jimbruges/birdbox/hardware/README.md

# BirdBox hardware

3D print files for BirdBox. Build instructions are in the main
[README](../README.md#building-the-hardware).

| File | What it is | Printing |
|---|---|---|
| `birdbox-mic-holder.stl` | Outdoor housing for the [Mini USB Microphone](https://thepihut.com/products/mini-usb-microphone) and its USB-C to USB-A adapter | Fill with silicone or hot glue after assembly, keeping the mic port clear |
| `birdbox-mic-holder.step` | Editable model of the mic holder | |
| `birdbox-servo-assembly-print-in-place.stl` | Linear servo assembly for an SG90-size servo (FS90R), printed in one piece | Mounting face on the build plate, organic supports |
| `birdbox-servo-assembly.step` | Editable model of the servo assembly | |
| `servo-gear.stl` | Pinion gear for the servo | |
| `servo-gear.step` | Editable model of the gear | |

## Credits and licence

The servo assembly is based on, and the servo gear comes from,
[Linear servo using SG90 9g servo](https://www.printables.com/model/1566678-linear-servo-using-sg90-9g-servo) by **lingeswaran** on Printables, licensed
Creative Commons Attribution (CC BY). The assembly has been modified for BirdBox.

These files are licensed under
[CC BY 4.0](https://creativecommons.org/licenses/by/4.0/). If you share or remix
them, credit both BirdBox and the original design.
