jimbruges/birdbox/docs/images/stills/15_cloud_dashboard.png

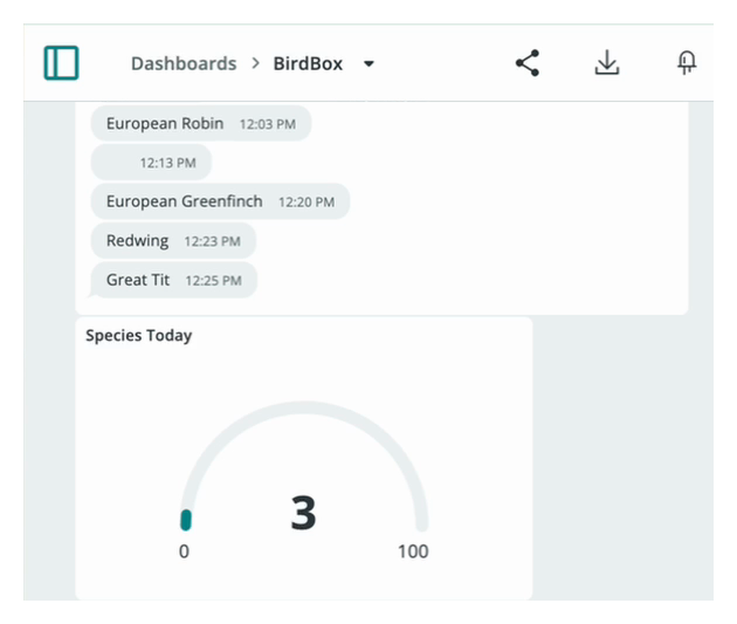
docs/images/stills/15_cloud_dashboard.png
