jimbruges/birdbox/hardware/birdbox-servo-assembly-print-in-place.stl

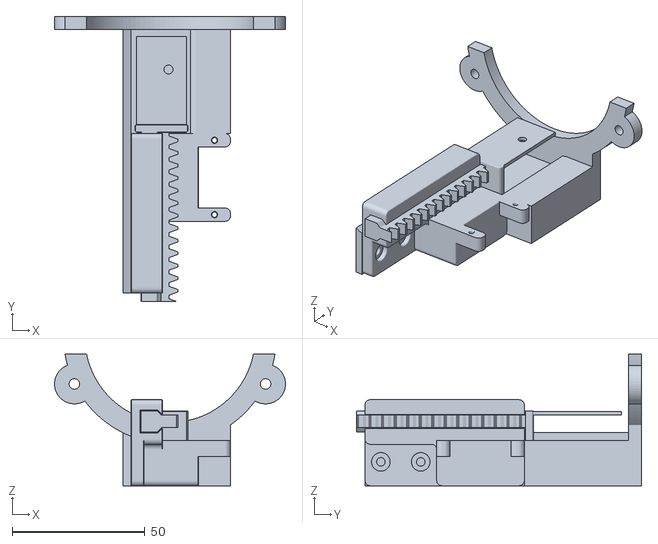
[picture p25: CAD file, 2026-11-09]
hardware/birdbox-servo-assembly-print-in-place.stl
86.9 x 107.3 x 49.5
