jimbruges/birdbox/hardware/birdbox-servo-assembly.step

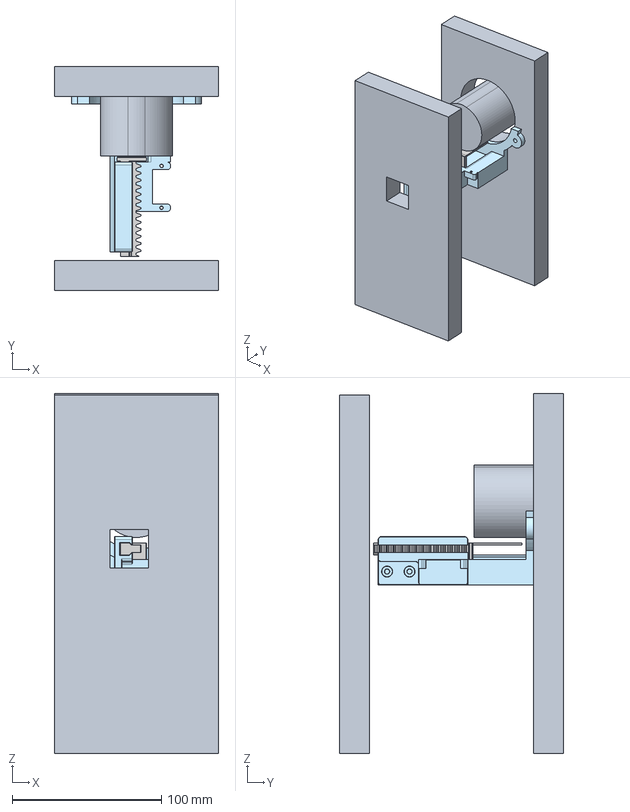
[picture p26: CAD file, 2026-11-09]
hardware/birdbox-servo-assembly.step
110.0 x 150.0 x 241.0 mm
