jimbruges/birdbox/hardware/birdbox-mic-holder.step

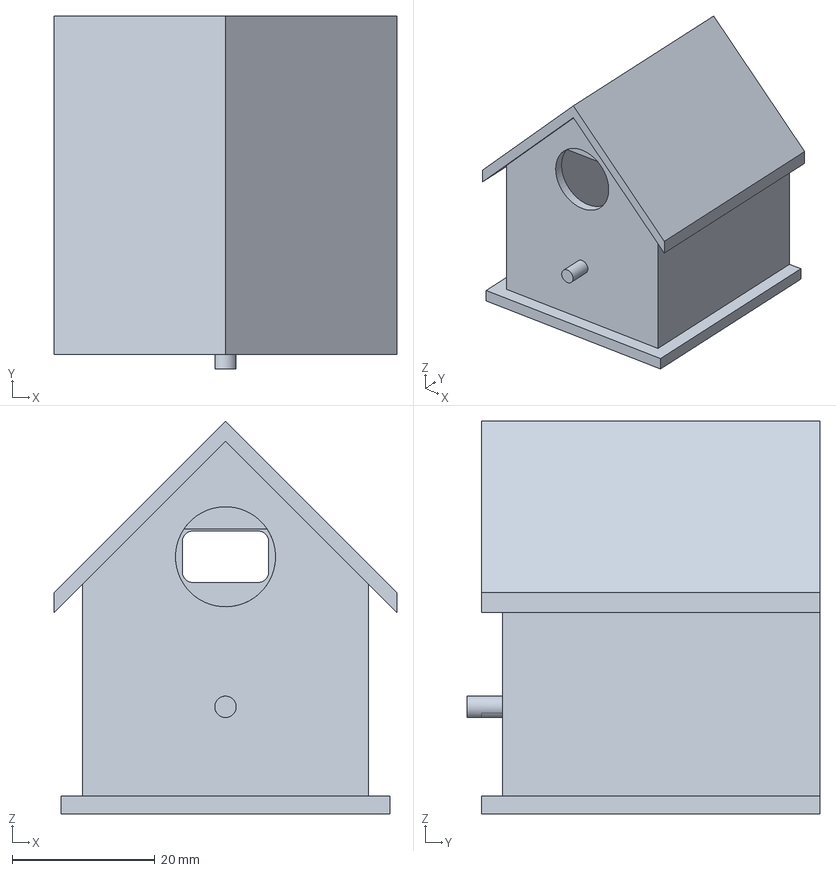
[picture p27: CAD file, 2026-11-09]
hardware/birdbox-mic-holder.step
48.0 x 49.4 x 55.0 mm
