jimbruges/birdbox/hardware/servo-gear.step

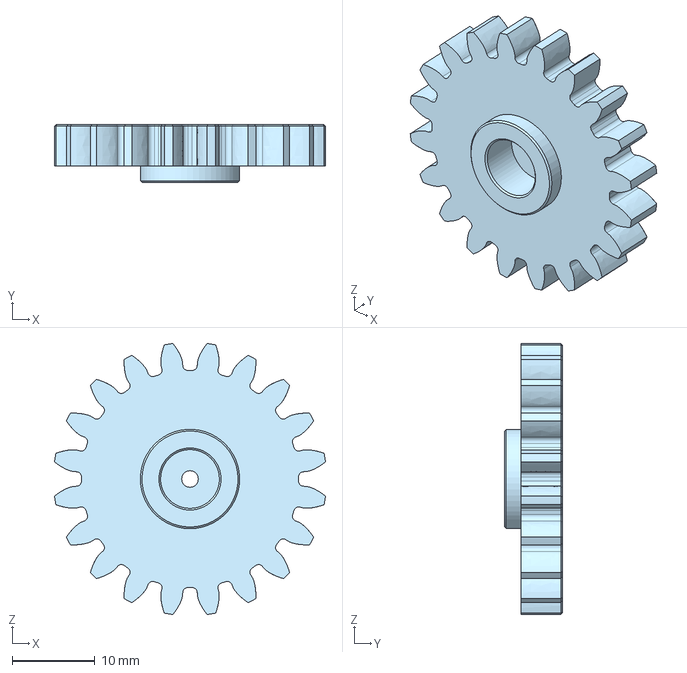
[picture p28: CAD file, 2026-11-09]
hardware/servo-gear.step
32.7 x 7.00 x 32.7 mm
