jimbruges/birdbox/(list of files, cad)

Other CAD files:
hardware/birdbox-mic-holder.stl
hardware/servo-gear.stl
