jimbruges/birdbox/docs/plan-v2-printer.md

# BirdBox v2 plan: thermal printer and buttons

v1.0 is tagged and released. v2 adds an optional thermal printer and one or two
panel-mount buttons on the base of the box. Everything here is optional: with no
printer or buttons connected, BirdBox behaves exactly as v1.0, and every receipt
can still be previewed on the debug page.

## Hardware

| Part | Notes |
|---|---|
| [RS PRO High Speed Thermal Line Panel Printer](https://uk.rs-online.com/web/p/panel-printers/1785731) (RS 178-5731) | 58 mm paper, 384 dots per line (8 dots/mm), USB 2.0 or RS-232. Powered from **3.5–8.5 V, up to 3 A**, so it needs its own supply: it can't run from the UNO Q or the hub's USB ports. |
| 1–2 momentary panel-mount push buttons | Normally open. One side to a digital pin, the other to GND. The sketch uses the internal pull-ups. |

- **Printer data:** a hardware UART on the MCU: `Serial3` on the SCL (TX) / SDA (RX) pins
  (originally `Serial1` on D0/D1, which is the Zephyr console and printed the boot banner),
  plus a shared GND. The app streams each receipt to the sketch over the Router
  Bridge in base64 chunks; the sketch keeps a 4 KB buffer and feeds the UART from
  `loop()` without blocking, so the servo and buzzer keep their timing. The UNO Q's
  pins are 3.3 V, so an RS-232 printer needs a MAX3232 level shifter. USART1 is also
  the Zephyr boot console, so a line of boot text may print at power-up. A USB
  printer on the hub is supported as an alternative.
- **Buttons:** two, on D2 and D3 by default, each to GND with internal pull-ups. The
  pins and each button's action (card, summary, scroll line, test, song or nothing)
  are settings, sent to the sketch with `button_set_pin()`.

## Receipts

All receipts are rendered on the board as 384-pixel-wide black-and-white images, styled
like an old encyclopaedia (serif type, inverted headwords, italic scientific names), and
sent as ESC/POS raster graphics, so the debug page preview is exactly what prints.
Paper use is measured in millimetres from the image height (8 px = 1 mm).

### 1. Bird card (button 1, or the `card` command)

For the last species detected:

- **Always:** common and scientific name, date and time, confidence, and how many
  times it's been heard today and in total.
- **Optional, set from the dashboard:**
  - **Picture:** a silhouette from [PhyloPic](https://www.phylopic.org/), placed
    beside the text so it costs no extra paper. Falls back to the genus when the
    species has none. Each image has its own licence (many are CC BY), so a
    one-line credit is printed when there's a picture.
  - **Song:** the buzzer song for that species, drawn as a pitch contour on a
    five-line staff. It's the same data the buzzer plays, so it exists for every
    species.
  - **Description:** a two-sentence encyclopaedia entry condensed from the species'
    Wikipedia introduction by the local LLM and checked against it, or the article's
    first sentence. Credited to Wikipedia.

Pictures and descriptions are fetched once per species, in the background when the
bird is first detected, and cached in `data/birdinfo/`. A button press then prints
straight away.

### 2. Detection scroll (`print_each_detection`, off by default)

One line per detection, about 3 mm of paper each, with no feed between lines, so the
paper builds up into a scroll of the day's birds. For example:
`07:14 European Robin 92%`.

### 3. Daily summary (button 2, the `summary` command, or at `summary_hour`)

- Date, total detections, distinct species and the busiest hour.
- The top five species, as horizontal bars.
- A 24-hour activity chart covering the last 24 hours.

It prints automatically once a day at `summary_hour` (0–23, or −1 for off).

## Data

Every detection is logged to SQLite at `data/birdbox.db`: time, species and
confidence. That gives the "seen N times" counts, the summary and the 24-hour chart,
and it survives restarts. v1.0 kept counts only in memory.

## Settings

New settings work like the existing ones: editable on the debug page, saved on the
board, and synced with Arduino Cloud where the Thing has the variable. The Pro
dashboard gets a Printer section.

| Setting | Type | Default | |
|---|---|---|---|
| `printer_enabled` | Boolean | `true` | Master switch. With no printer found, prints are skipped and logged. |
| `print_each_detection` | Boolean | `false` | Detection scroll. |
| `card_picture` | Boolean | `true` | Silhouette on the bird card. |
| `card_song` | Boolean | `true` | Vocalisation Chart on the bird card. |
| `card_description` | Boolean | `true` | Encyclopaedia entry on the bird card. |
| `card_llm` | Boolean | `true` | Write the entry with the local LLM; otherwise the first sentence of Wikipedia. |
| `summary_hour` | Integer | `-1` | Hour for the daily summary, −1 for off. |
| `card_credits` | Boolean | `true` | Small picture and text credits on the card. |
| `printer_port`, `printer_baud`, `printer_device` | board only | `serial`, `9600`, `auto` | How the printer is connected. |
| `button1_pin`, `button1_action`, `button2_pin`, `button2_action` | board only | `2`, `card`, `3`, `summary` | What each button does and where it's wired. |

The existing `servo_command` Messenger also accepts `card`, `summary` and `line`.

## Ideas tested

- **Local LLM summary.** First attempt: Qwen 3.5 0.8B (already installed on the
  board) given the short Wikipedia summary and asked for one sentence. It took 25–37 s
  and wasn't reliable: two of three were accurate but bland, and for the robin it wrote
  "European robin migrates north to winter", which misreads the source.

  Second attempt, borrowing from *This Fish Does Not Exist* (lazy brick import, a
  timeout thread, a style preamble, cleaning and a fallback): give the model the
  article's whole introduction, ask it to **condense** into a two-sentence entry for
  "an old encyclopaedia of British birds" using only facts stated, then **check the
  reply against the source**. Content words must appear in the source (by five-letter
  stem), and below 90% the reply is rejected. Six test species all came back accurate
  and fully grounded, at 30–100 s each.

  That's too slow to wait for, so each species keeps one cached entry, written in the
  background when it's first heard. Printing uses the cached entry and queues a new
  one with a different focus (plumage, range, food, behaviour), so cards vary without
  waiting. The first sentence of Wikipedia is the fallback. The model takes about
  480 MB, which fits beside BirdNET on the 2 GB board.
- **"Sheet music" for the song.** The songs are pitch sweeps, not notes, so real
  notation would invent rhythm and pitches. A pitch contour drawn on a staff is honest
  about what the buzzer plays and is only about 5 mm tall.
- **PhyloPic.** Has silhouettes rather than line drawings, which print cleanly on a
  thermal printer. Coverage is good for UK garden birds at species or genus level.

## Not doing (yet)

- QR codes linking to recordings or a species page
- Cutting the paper (this printer has no cutter); you tear it at the bar
- Printing from Arduino Cloud chart data; the summary uses the local SQLite log

## Printer findings (SP-RMD9 manual and test prints)

The RS PRO 178-5731 is a rebadged SPRT SP-RMD9. Test prints over D0/D1:

- **Plain text** printed correctly at the configured baud, so the wiring was fine.
- **`GS v 0`** (ESC/POS raster) and **`DC2 *`** (CSN-A2) aren't in its command set;
  the printer printed the image bytes as characters.
- **`ESC *`** printed the picture in 24-dot strips with gaps, because `ESC 3` (line
  spacing) isn't one of its commands either.
- Its manual's image command is **`ESC K nL nH data`**: 8-dot-tall lines, one byte
  per column, top dot first, up to 384 wide. Line spacing is **`ESC 1 n`** in dots,
  and 0 makes image lines touch. That's now the default encoding.
- It has a 3 KB buffer and RTS/CTS flow control on its CTS pin, which the sketch can
  watch on an optional busy pin. It also supports `DLE EOT` status, `ESC J` feed in
  dots, and ships at 9600 baud with the print direction set to *Reverse*.

On paper, full-width one-dot rules and thin strokes disappeared: the head limits how
many dots it heats in one row. Rules are now 2-dot dashes at half density, and bars
and the Vocalisation Chart use a 2×2-block grey. Descriptions are fitted to five lines
and always end on a complete sentence.

`Serial1` on D0/D1 is the MCU's Zephyr console, so the loader printed its boot banner
on the printer at every MCU reset. The printer moved to `Serial3` on the SCL/SDA pins
(free, since the Modulino uses the separate Qwiic bus), which stays silent until the
app opens it. D0/D1 is still selectable.

A **Demo scroll** on the debug page pops out a random bird, plays its song and prints
its scroll line every N seconds, X times, for filming. Demo birds aren't logged or
sent to the Cloud.
