jimbruges/birdbox/docs/images/stills/05_build_finished_top.jpg

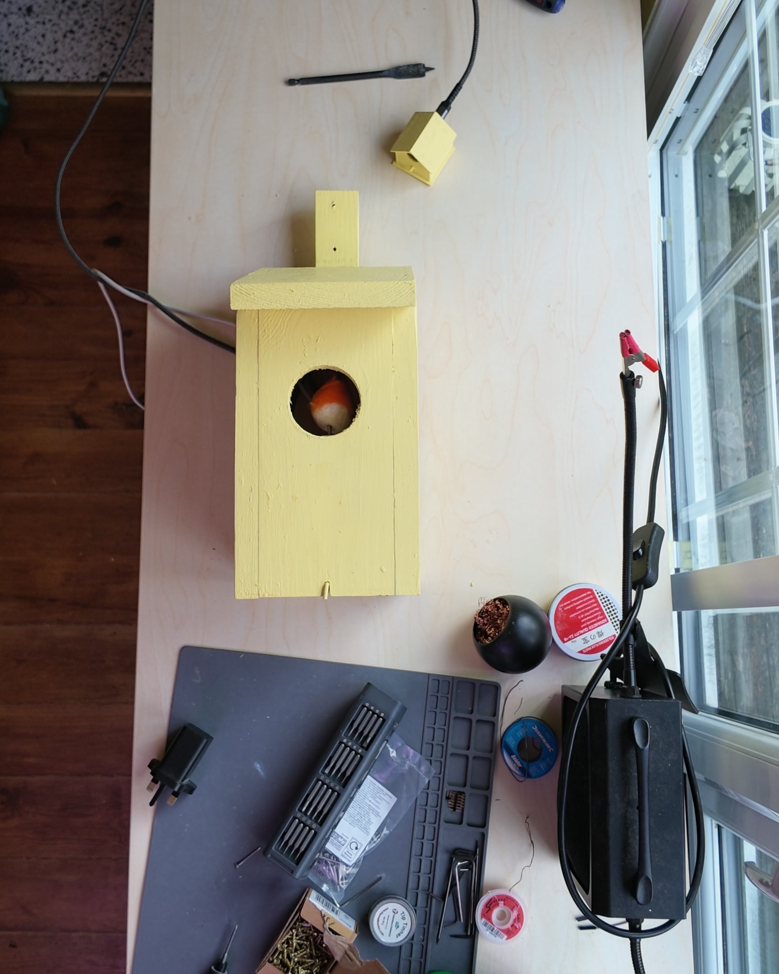
docs/images/stills/05_build_finished_top.jpg
