jimbruges/birdbox/python/printer.py

# SPDX-License-Identifier: MPL-2.0
"""ESC/POS output to a thermal printer, run from a background queue.

Receipts arrive as 1-bit images and are sent as bit-image graphics, so what
prints is exactly what the debug page previews. Printers differ in which image
command they understand, so there are three encodings (RASTER_MODES); the debug
page's printer tests show which one a printer takes.

Two ways to reach the printer:
- "serial" (default): the MCU's hardware serial pins D0/D1. The bytes go to the
  sketch over the Router Bridge in base64 chunks; it buffers them and feeds the
  UART at the printer's baud rate.
- "usb": a USB printer on the hub, written directly from Linux.

With no printer attached, jobs are dropped (USB) or simply go nowhere (serial),
and the rest of the app carries on.
"""

from __future__ import annotations

import base64
import glob
import os
import queue
import termios
import threading
import time

from PIL import Image

from arduino.app_utils import Logger

logger = Logger("Printer")

# Where a USB printer shows up: the printer class driver, USB serial, or a
# USB-to-RS-232 adapter.
CANDIDATES = ("/dev/usb/lp*", "/dev/ttyACM*", "/dev/ttyUSB*")
SERIAL_BAUD = termios.B9600     # only matters for a real RS-232 link
BAND_ROWS = 128                 # rows per raster command; keeps each write small
TEAR_FEED_MM = 22               # default feed after a card or summary, so it clears the box

ESC_INIT = b"\x1b@"
CHUNK = 144                     # raw bytes per Bridge call: 192 base64 chars, inside the RPC buffer
BAUD_RATES = (9600, 19200, 38400, 57600, 115200)


def find_device(setting: str = "auto") -> str | None:
    if setting and setting != "auto":
        return setting if os.path.exists(setting) else None
    for pattern in CANDIDATES:
        found = sorted(glob.glob(pattern))
        if found:
            return found[0]
    return None


def _black_rows(image: Image.Image) -> tuple[bytes, int, int]:
    """Row-major packed bits with 1 = black: (data, width in bytes, height)."""
    img = image.convert("1")
    # PIL packs mode "1" with 1 = white; printers want 1 = black.
    return bytes(b ^ 0xFF for b in img.tobytes()), (img.width + 7) // 8, img.height


def raster_gs_v0(image: Image.Image) -> bytes:
    """GS v 0: the modern ESC/POS raster command."""
    data, width_bytes, height = _black_rows(image)
    out = bytearray()
    for top in range(0, height, BAND_ROWS):
        rows = min(BAND_ROWS, height - top)
        band = data[top * width_bytes:(top + rows) * width_bytes]
        out += b"\x1dv0\x00" + bytes((width_bytes & 0xFF, width_bytes >> 8, rows & 0xFF, rows >> 8)) + band
    return bytes(out)


def raster_dc2_star(image: Image.Image) -> bytes:
    """DC2 *: the raster command of the CSN-A2 / Adafruit family of panel printers."""
    data, width_bytes, height = _black_rows(image)
    out = bytearray()
    for top in range(0, height, 255):
        rows = min(255, height - top)
        out += b"\x12*" + bytes((rows, width_bytes)) + data[top * width_bytes:(top + rows) * width_bytes]
    return bytes(out)


def raster_esc_star(image: Image.Image, spacing: int = 24) -> bytes:
    """ESC * 33: the older column-based bit image, printed in 24-dot bands.

    Between bands the printer feeds one line, set with ESC 3 to `spacing`. Printers
    measure that in different units (dots on most, 1/180 inch or similar on
    others), so it's a setting: the right value makes the bands just touch.
    """
    img = image.convert("1")
    width, height = img.size
    px = img.load()
    out = bytearray(b"\x1b3" + bytes((max(1, min(255, spacing)),)))
    for top in range(0, height, 24):
        out += b"\x1b*\x21" + bytes((width & 0xFF, width >> 8))
        for x in range(width):
            for k in range(3):
                byte = 0
                for bit in range(8):
                    y = top + k * 8 + bit
                    if y < height and px[x, y] == 0:      # 0 = black in mode "1"
                        byte |= 0x80 >> bit
                out.append(byte)
        out += b"\n"
    out += b"\x1b2"                                     # back to the default line spacing
    return bytes(out)


def raster_esc_k(image: Image.Image, reverse: bool = True) -> bytes:
    """ESC K: 8-dot-tall bit-image lines, the image command of SPRT panel printers.

    The RS PRO 178-5731 is an SPRT SP-RMD9. Its manual: ESC K nL nH, then one byte
    per column (top dot = most significant bit), width up to 384; and ESC 1 0 sets
    the line spacing to 0 dots so consecutive 8-dot lines touch.

    In the printer's Reverse direction (its factory setting, so receipts read the
    right way up as they leave a panel) it turns every printed line by 180°. With
    `reverse`, each 8-dot line is pre-rotated so it comes out the right way up.
    """
    img = image.convert("1")
    width, height = img.size
    if height % 8:
        # Pad to whole 8-dot lines so a rotated line keeps its content in place.
        padded = Image.new("1", (width, height + 8 - height % 8), 1)
        padded.paste(img, (0, 0))
        img, height = padded, padded.height
    out = bytearray(b"\x1b1\x00")                       # ESC 1 0: no gap between image lines
    for top in range(0, height, 8):
        band = img.crop((0, top, width, top + 8))
        if reverse:
            band = band.rotate(180)
        px = band.load()
        out += b"\x1bK" + bytes((width & 0xFF, width >> 8))
        for x in range(width):
            byte = 0
            for bit in range(8):
                if px[x, bit] == 0:                       # 0 = black in mode "1"
                    byte |= 0x80 >> bit
            out.append(byte)
        out += b"\n"
    out += b"\x1b1\x06"                                 # back to the text line spacing (6 dots)
    return bytes(out)


RASTER_MODES = {"esc_k": raster_esc_k, "gs_v0": raster_gs_v0, "esc_star": raster_esc_star,
                "dc2_star": raster_dc2_star}


def raster(image: Image.Image, mode: str = "gs_v0", spacing: int = 24, reverse: bool = True) -> bytes:
    if mode == "esc_star":
        return raster_esc_star(image, spacing)
    if mode == "esc_k":
        return raster_esc_k(image, reverse)
    return RASTER_MODES.get(mode, raster_gs_v0)(image)


def feed(dots: int) -> bytes:
    """ESC J: feed paper by `dots` (8 per mm)."""
    out = bytearray()
    while dots > 0:
        step = min(255, dots)
        out += b"\x1bJ" + bytes((step,))
        dots -= step
    return bytes(out)


class Printer:
    """Queues receipts and writes them to the printer one at a time."""

    def __init__(self, bridge_call) -> None:
        self.port = "serial"            # "serial" (MCU D0/D1) or "usb"
        self.baud = 9600
        self.uart = 3                   # 3 = Serial3 on SCL/SDA (D21 TX, D20 RX); 1 = Serial1 on D0/D1
        self.device_setting = "auto"    # USB only
        self.raster_mode = "esc_k"
        self.line_spacing = 24          # ESC * only: ESC 3 value that makes 24-dot bands touch
        self.reverse = True             # ESC K only: printer set to Reverse direction (SPRT default)
        self.feed_mm = TEAR_FEED_MM     # feed after cards and summaries (scroll lines get none)
        self.flip = True                # turn the whole receipt 180° (it comes out the other way round)
        self.status: int | None = None  # last ESC/POS status byte over serial, -1 = no reply
        self.last_error: str | None = None
        self.printed = 0
        self._bridge_call = bridge_call
        self._jobs: queue.Queue = queue.Queue(maxsize=50)
        threading.Thread(target=self._worker, name="printer", daemon=True).start()

    @property
    def device(self) -> str | None:
        """Where jobs go, or None when there's nowhere to send them."""
        if self.port == "serial":
            pins = "D0/D1" if self.uart == 1 else "SCL/SDA"
            return f"MCU serial {pins} at {self.baud} baud"
        return find_device(self.device_setting)

    @property
    def busy(self) -> bool:
        return not self._jobs.empty()

    def begin(self) -> None:
        """(Re)start the MCU's UART at the configured baud rate."""
        if self.port == "serial":
            self._bridge_call("printer_begin", self.baud, self.uart)

    def check(self) -> int | None:
        """Ask a serial printer for its status; -1 means it didn't answer."""
        if self.port != "serial" or self.busy:
            return self.status
        try:
            self.status = int(self._bridge_call("printer_status"))
        except Exception as err:  # noqa: BLE001 - sketch not up yet
            logger.info(f"Printer status unavailable: {err}")
        return self.status

    def describe_status(self) -> str:
        if self.port != "serial":
            return "found" if self.device else "not found"
        if self.status is None:
            return "not checked"
        if self.status == -1:
            return "no reply (printer off, or its TX not wired to the MCU's RX pin)"
        if self.status == -2:
            return "printing"
        return "ready" if self.status & 0x08 == 0 else "offline"

    def submit(self, image: Image.Image, label: str, tear: bool = True, mode: str | None = None) -> bool:
        """Queue an image. Returns False (and logs) when there's no printer to send to."""
        return self._queue((image, label, tear, mode))

    def submit_raw(self, data: bytes, label: str) -> bool:
        """Queue ready-made printer bytes (tests)."""
        return self._queue((data, label, True, None))

    def submit_text(self, text: str, label: str) -> bool:
        """Queue plain ASCII text, for checking the wiring and baud rate."""
        return self._queue((text.encode("ascii", "replace"), label, True, None))

    def _queue(self, job: tuple) -> bool:
        label = job[1]
        if self.device is None:
            logger.info(f"No printer found, skipping {label}")
            return False
        try:
            self._jobs.put_nowait(job)
        except queue.Full:
            logger.warning(f"Print queue full, dropping {label}")
            return False
        return True

    def _worker(self) -> None:
        while True:
            content, label, tear, mode = self._jobs.get()
            if self.flip and not isinstance(content, bytes):
                content = content.rotate(180)
            body = content if isinstance(content, bytes) else raster(content, mode or self.raster_mode,
                                                                     self.line_spacing, self.reverse)
            payload = ESC_INIT + body + (feed(self.feed_mm * 8) if tear else b"")
            try:
                self._write(payload)
                self.printed += 1
                self.last_error = None
                size = f"{content.height / 8:.0f} mm" if not isinstance(content, bytes) else f"{len(content)} bytes"
                logger.info(f"Printed {label} ({size}, {len(payload)} bytes sent)")
            except OSError as err:
                self.last_error = str(err)
                logger.warning(f"Could not print {label}: {err}")

    def _write(self, payload: bytes) -> None:
        if self.port == "serial":
            self._write_serial(payload)
        else:
            self._write_usb(payload)

    def _write_serial(self, payload: bytes) -> None:
        """Stream to the sketch's print buffer, waiting whenever it's full."""
        for start in range(0, len(payload), CHUNK):
            chunk = base64.b64encode(payload[start:start + CHUNK]).decode()
            deadline = time.monotonic() + 30
            while True:
                try:
                    free = int(self._bridge_call("printer_write", chunk))
                except Exception as err:  # noqa: BLE001
                    raise OSError(f"sketch not answering: {err}") from err
                if free >= 0:
                    break
                if time.monotonic() > deadline:
                    raise OSError("printer buffer stayed full for 30 s")
                # The buffer drains at the baud rate (about 1 KB/s at 9600).
                time.sleep(0.05)

    def _write_usb(self, payload: bytes) -> None:
        path = self.device
        if path is None:
            raise OSError("printer disconnected")
        fd = os.open(path, os.O_WRONLY | os.O_NOCTTY)
        try:
            if "tty" in path:
                attrs = termios.tcgetattr(fd)
                attrs[0] = 0                                    # iflag: raw
                attrs[1] = 0                                    # oflag: no CR/LF translation
                attrs[2] = termios.CS8 | termios.CREAD | termios.CLOCAL
                attrs[3] = 0                                    # lflag: raw
                attrs[4] = attrs[5] = SERIAL_BAUD
                termios.tcsetattr(fd, termios.TCSANOW, attrs)
            view = memoryview(payload)
            while view:
                written = os.write(fd, view[:4096])
                view = view[written:]
                time.sleep(0.005)                               # let a slow USB printer keep up
        finally:
            os.close(fd)
