jimbruges/birdbox/python/history.py

# SPDX-License-Identifier: MPL-2.0
"""Detection log in SQLite, for "seen N times" counts and the daily summary.

Times are stored as local timestamps (the board's timezone), so "today" and the
hour of day match what the dashboard shows.
"""

from __future__ import annotations

import sqlite3
import threading
from datetime import datetime, timedelta
from pathlib import Path

DB_FILE = Path(__file__).resolve().parent.parent / "data" / "birdbox.db"

_lock = threading.Lock()
_db: sqlite3.Connection | None = None


def _conn() -> sqlite3.Connection:
    global _db
    if _db is None:
        DB_FILE.parent.mkdir(parents=True, exist_ok=True)
        _db = sqlite3.connect(DB_FILE, check_same_thread=False)
        _db.execute(
            "CREATE TABLE IF NOT EXISTS detections ("
            " ts REAL NOT NULL, day TEXT NOT NULL, hour INTEGER NOT NULL,"
            " scientific TEXT NOT NULL, common TEXT NOT NULL, confidence REAL NOT NULL)"
        )
        _db.execute("CREATE INDEX IF NOT EXISTS detections_day ON detections(day)")
        _db.execute("CREATE INDEX IF NOT EXISTS detections_species ON detections(scientific)")
        _db.commit()
    return _db


def record(when: datetime, scientific: str, common: str, confidence: float) -> None:
    with _lock:
        db = _conn()
        db.execute(
            "INSERT INTO detections VALUES (?, ?, ?, ?, ?, ?)",
            (when.timestamp(), when.strftime("%Y-%m-%d"), when.hour, scientific, common, confidence),
        )
        db.commit()


def last() -> dict | None:
    """The most recent detection."""
    with _lock:
        row = _conn().execute(
            "SELECT ts, scientific, common, confidence FROM detections ORDER BY ts DESC LIMIT 1"
        ).fetchone()
    if row is None:
        return None
    return {"when": datetime.fromtimestamp(row[0]), "scientific": row[1], "common": row[2], "confidence": row[3]}


def counts(scientific: str, day: str | None = None) -> tuple[int, int]:
    """(times heard on `day`, times heard ever) for one species."""
    day = day or datetime.now().strftime("%Y-%m-%d")
    with _lock:
        db = _conn()
        today = db.execute(
            "SELECT COUNT(*) FROM detections WHERE scientific = ? AND day = ?", (scientific, day)
        ).fetchone()[0]
        total = db.execute("SELECT COUNT(*) FROM detections WHERE scientific = ?", (scientific,)).fetchone()[0]
    return today, total


def day_summary(day: str | None = None, top: int = 5) -> dict:
    """Totals and top species for one day."""
    day = day or datetime.now().strftime("%Y-%m-%d")
    with _lock:
        db = _conn()
        total, species = db.execute(
            "SELECT COUNT(*), COUNT(DISTINCT scientific) FROM detections WHERE day = ?", (day,)
        ).fetchone()
        leaders = db.execute(
            "SELECT common, scientific, COUNT(*) AS n FROM detections WHERE day = ?"
            " GROUP BY scientific ORDER BY n DESC, MAX(ts) DESC LIMIT ?",
            (day, top),
        ).fetchall()
    return {"day": day, "total": total, "species": species,
            "top": [{"common": c, "scientific": s, "count": n} for c, s, n in leaders]}


def hourly_last_24h(now: datetime | None = None) -> list[tuple[int, int]]:
    """Detections per clock hour over the last 24 hours, oldest first: [(hour, count)]."""
    now = now or datetime.now()
    end = now.replace(minute=0, second=0, microsecond=0) + timedelta(hours=1)
    start = end - timedelta(hours=24)
    with _lock:
        rows = _conn().execute(
            "SELECT ts FROM detections WHERE ts >= ? AND ts < ?", (start.timestamp(), end.timestamp())
        ).fetchall()
    buckets = [0] * 24
    for (ts,) in rows:
        buckets[int((ts - start.timestamp()) // 3600)] += 1
    return [((start + timedelta(hours=k)).hour, buckets[k]) for k in range(24)]


def recent(limit: int = 20) -> list[dict]:
    with _lock:
        rows = _conn().execute(
            "SELECT ts, common, confidence FROM detections ORDER BY ts DESC LIMIT ?", (limit,)
        ).fetchall()
    return [{"when": datetime.fromtimestamp(t), "common": c, "confidence": conf} for t, c, conf in rows]
