jimbruges/birdbox/(commit log)

2026-11-09 BirdBox: on-device BirdNET bird box for the Arduino UNO Q
    Listens on a microphone, identifies birds with BirdNET V2.4 in a custom
    App Lab brick, publishes detections to Arduino Cloud, pushes a model bird
    out on an FS90R servo rail and plays a simulated song for the species on
    a Modulino Buzzer. Includes a debug web UI that can change and persist
    every setting, Arduino Cloud and dashboard setup docs, and a Project Hub
    write-up draft.
    [main.py, sketch.ino, songs.py]
2026-11-09 Add 3D print files and hardware build guide
    Adds the outdoor mic holder, the print-in-place linear servo assembly and
    the servo gear (STL + STEP) under hardware/, with build steps in the README
    and the Project Hub draft. The servo assembly is based on, and the gear
    taken from, "Linear servo using SG90 9g servo" by lingeswaran (CC BY).
    [birdbox-mic-holder.step, birdbox-mic-holder.stl, birdbox-servo-assembly-print-in-place.stl, birdbox-servo-assembly.step, servo-gear.step, servo-gear.stl]
2026-11-10 Document that a USB mic needs a powered hub
    The UNO Q's USB-C port is power-sink only, so a bus-powered mic plugged
    in directly (or through a passive adapter) gets no VBUS and never enumerates.
2026-11-10 Power from the Arduino USB-C Hub, and sing the robin on test
    Docs now use the Arduino USB-C Hub (8-in-1) with a PD supply to power the
    board and the USB mic, replacing VIN. The test action always plays the
    European Robin; the song command falls back to it before any detection.
2026-11-10 Recommend a basic 5 W charger for the hub
2026-11-11 Set up Arduino Cloud via the API, with Free and Pro dashboards
    tools/setup_cloud.py creates the Thing variables and the BirdBox Free and
    BirdBox Pro dashboards through the Arduino Cloud API, using an API key
    saved outside the repo. The app now publishes a detection_log line per
    detection for the Pro dashboard's running log.
2026-11-11 Add dashboard stills and GIFs; keep last detection across restarts
    Dashboard screenshots and GIFs extracted from screen recordings are in
    docs/images and shown in the README, the Cloud guide and the Project Hub
    draft. The last-detection variables now use CLOUD_WINS, so an app restart
    no longer pushes blank values that show up as empty Messenger entries.
    [main.py]
2026-11-11 Use high-res dashboard screenshots; describe songs plainly
    Replace the blurry dashboard stills with full-resolution screenshots and
    drop the phone stills (the GIFs stay). The 70 species songs are generated
    approximations, so describe them as predefined songs rather than
    hand-made, and tone down promotional wording in the docs.
    [main.py, songs.py]
2026-11-11 Add build photos and cover image to the README and Project Hub draft
    Also fix a broken Printables link in the README and describe the buzzer
    song plainly in the introduction.
2026-11-11 Fix Project Hub draft wording: mic cable goes to the hub, plainer song wording
2026-11-11 Add wiring diagram and debug UI screenshot to the docs
2026-11-12 v2: optional thermal printer and panel buttons
    Bird cards, a detection scroll and a daily summary, rendered as
    encyclopaedia-style 384-dot receipts and sent as ESC/POS raster to a USB
    thermal printer. Cards can include a PhyloPic silhouette, the song as a
    pitch contour, and a short entry the local LLM condenses from Wikipedia
    and checks against the source; one entry is cached per species and
    replaced after each print. Detections are logged to SQLite for counts and
    the summary. Two optional buttons on D2/D3 print the card and summary.
    Everything previews on the debug page, and works without the hardware.
    [birdinfo.py, history.py, main.py, printer.py, receipts.py, sketch.ino]
2026-11-12 Printer on the MCU serial pins; configurable buttons; small optional credits
    The printer now connects to Serial1 (D0/D1): receipts stream to the sketch
    over the Bridge in base64 chunks and drain from a 4 KB buffer at the set
    baud rate, with an ESC/POS status check over D0. USB printers still work.
    Both buttons' pins and actions are settings. Card credits print in 10 px
    type and can be turned off, and the song strip is labelled as a pitch
    contour. PhyloPic 404s now fall back to the genus.
2026-11-12 Printer tests and a choice of image command
    Some panel printers don't understand ESC/POS GS v 0 and print the image
    data as text. Adds ESC * and DC2 * encodings, a printer_raster setting,
    and debug-page tests: a plain-text wiring check and a test pattern in
    each image format.
2026-11-12 ESC * band spacing setting and a spacing calibration print
    The printer only understands ESC * bit images, and its ESC 3 line-spacing
    unit isn't dots, which left gaps between 24-dot bands. The spacing is now
    a setting, with a test print that shows several labelled values.
2026-11-12 Print images with ESC K for the SPRT SP-RMD9 (RS PRO 178-5731)
    The printer's manual lists ESC K (8-dot bit-image lines) with ESC 1 n line
    spacing, not GS v 0 or DC2 *, which it printed as text. ESC K is now the
    default image command. Adds an optional CTS busy pin so the sketch pauses
    when the printer's 3 KB buffer is full, and documents the printer's
    serial pinout, baud setup and command set.
2026-11-12 Turn ESC K lines the right way up in the printer's Reverse direction
    The SP-RMD9 ships set to Reverse, which rotates every printed line 180°
    so text reads correctly leaving the panel. Images now pre-rotate each
    8-dot line to match, with a printer_reverse setting for printers set to
    Normal.
    [main.py, printer.py]
2026-11-12 Pace printing and support the printer's CTS busy line
    Overflowing the SP-RMD9's 3 KB buffer printed the rest of a card as
    garbage. The sketch now limits image data to a print speed setting
    (10 mm/s by default) and can pause on the printer's CTS line, with
    configurable polarity and its live state on the debug page.
2026-11-12 Thermal-friendly lines: dashed 2-dot rules and a bolder song strip
    Full-width one-dot rules and the thin staff were lost on the SP-RMD9,
    which limits how many dots it heats in one row. Rules and the chart
    baseline are now 2-dot dashes at half density; the song staff is sparse
    2x2 dots and the contour 6 dots thick.
2026-11-12 Dithered bars and Vocalisation Chart; descriptions end on whole sentences
    Register bars, the activity chart and the song strip now print in a
    2x2-block grey, which a thermal head renders more evenly than solid
    runs. The song strip is titled Vocalisation Chart. Descriptions are
    fitted to five lines and always end on a complete sentence, and LLM
    replies are trimmed to their last full sentence.
2026-11-12 Smaller scroll lines with the date
    Scroll lines now show date and time in 10 px bold (1.6 mm a line, down
    from 2.9 mm), with 2x2 leader dots that print reliably, and a board-only
    setting for 9-13 px.
2026-11-12 Option to flip the whole receipt 180 degrees
    Turns each receipt image before encoding, so it comes out the other way
    round as a whole (not line by line). On by default for the prototype's
    printer mounting.
    [main.py, printer.py]
2026-11-12 Setting for the feed after cards and summaries
    Defaults to 22 mm (up from a fixed 12 mm) so a receipt clears the bird
    box; scroll lines still get no feed.
    [main.py, printer.py]
2026-11-12 Demo scroll for timelapses; printer off the boot console
    Adds a debug-page demo that pops out a random bird, plays its song and
    prints its scroll line every N seconds (optionally randomised), X
    times, without logging it. The printer now defaults to Serial3 on the
    SCL/SDA pins: D0/D1 is the MCU's Zephyr console, so the loader's boot
    banner printed on every MCU reset. D0/D1 stays selectable.
    [main.py, printer.py, sketch.ino]
2026-11-12 Docs: README and Project Hub draft for both stages
    The README introduces the two stages (v1.0 listening box, then the
    optional printer and buttons), updates the system diagram and parts
    list, and documents the printer's board-only settings and mounting.
    The Project Hub draft is reorganised as Stage 1 and Stage 2, including
    what it took to get the panel printer working.
